laukik-hase/human_arm_imitation/README.md

# Imitation of Human Arm using a 5-DoF Manipulator

<!-- TABLE OF CONTENTS -->

## Table of Contents

- [Imitation of Human Arm using a 5-DoF Manipulator](#imitation-of-human-arm-using-a-5-dof-manipulator)
  - [Table of Contents](#table-of-contents)
  - [About The Project](#about-the-project)
  - [Contributors](#contributors)
  - [Resources](#resources)
  - [Acknowledgements](#acknowledgements)
  - [License](#license)

<!-- ABOUT THE PROJECT -->

## About The Project

- The project aims at develop a 5-DoF manipulator capable of precise imitation of the human arm. The manipulator will be tested in a simulated environment and then implemented in reality.

- The first challenge is to track the position of human joints and acquire joint parameters data.
A motion-capture system consisting of IMU sensors attached to the human arm will be used for the purpose.

- The next challenge is to map the motion of the human to the manipulator, with kinematic and dynamic
modeling of the manipulator for precise and accurate control.

- After establishing a stable system for arm imitation, it will be tested on applications like pick-and-place and tracing a curve.

- Everything about the project: reports, progress, demos (photos and videos) can be found [here](https://drive.google.com/drive/folders/1VRj0Rsg3wywi9sTcepC8vw8A19dxCz2f?usp=sharing).

- For detailed description of the project, view this [report](human_arm_imitation.pdf).

## Contributors

* [Vishnuparammal](https://github.com/Vishnuparammal)
* [ved29](https://github.com/ved29)
* [laukik-hase](https://github.com/laukik-hase)
* [ameya-apte](https://github.com/ameya-apte)

<!-- Acknowledgements and Resources-->

## Resources
- [Concept Development Report](https://drive.google.com/drive/folders/1PC-iJiLeUT0hi6oHv0CTknUYlQUyzkWc?usp=sharing)
- [Progress Status](https://drive.google.com/drive/folders/1OLMFB2oo_8WZqaWDnTHkVBi_Prd8paOJ?usp=sharing)
- [References](https://drive.google.com/drive/folders/1Bxyq7_aq28y-IdtfYdROcifC5CevMQnE?usp=sharing)
## Acknowledgements

- [AVITRA : 2019-2020](https://github.com/SRA-AVITRA)
- [AVITRA : 2018-2019](https://github.com/atharvkhadtare/fyp_ws)
- [AVITRA : 2017-2018](https://github.com/sachin0x18/Imitation)

<!-- LICENSE -->

## License

Distributed under the MIT License. See `LICENSE` for more information.
