laukik-hase/human_arm_imitation/arm_imitation/meshes/link1_MOI_calc_from_meshlab.png

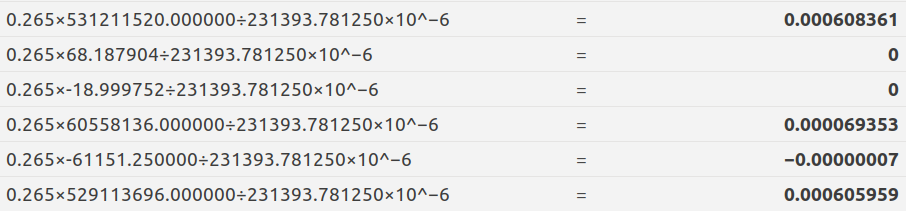
arm_imitation/meshes/link1_MOI_calc_from_meshlab.png
