laukik-hase/human_arm_imitation/arm_imitation/meshes/link2_MOI_calc_from_meshlab.png

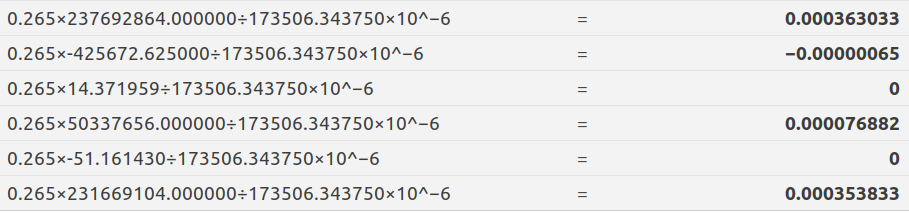
arm_imitation/meshes/link2_MOI_calc_from_meshlab.png
