laukik-hase/human_arm_imitation/arm_imitation/meshes/mx-64_MOI_calc_from_meshlab.png

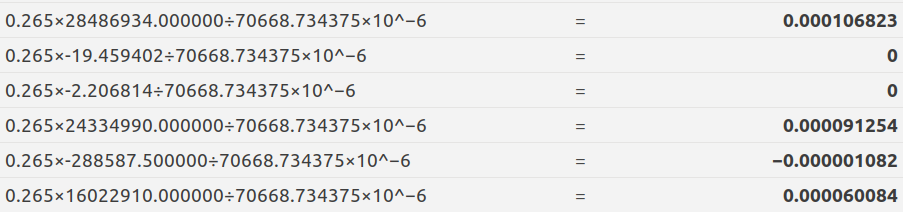
arm_imitation/meshes/mx-64_MOI_calc_from_meshlab.png
