laukik-hase/human_arm_imitation/pcb_designs/bno055/bno055.png

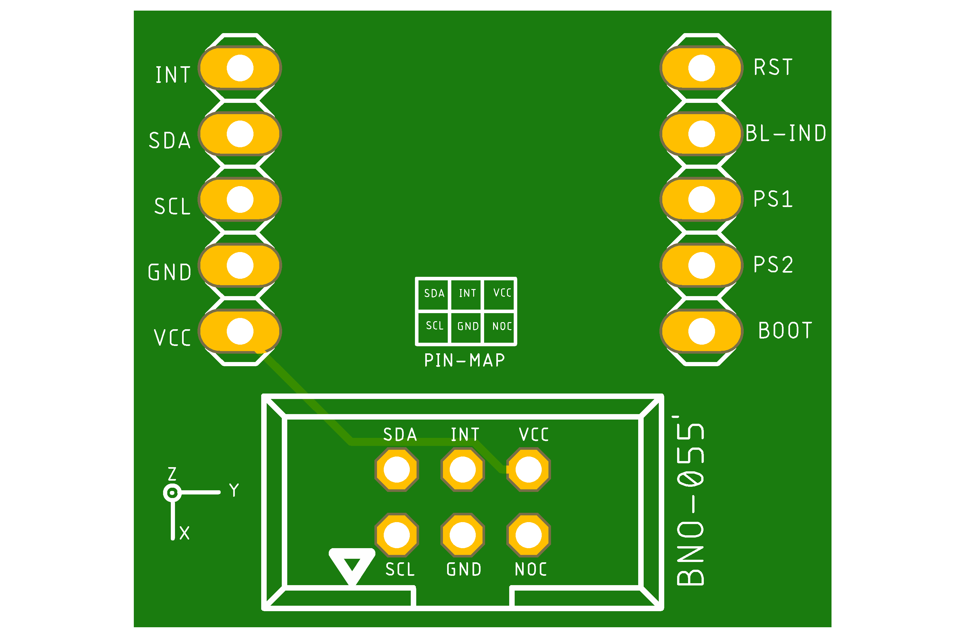
pcb_designs/bno055/bno055.png
