laukik-hase/human_arm_imitation/pcb_designs/esp32_breakout/fyp_board_rev4.png

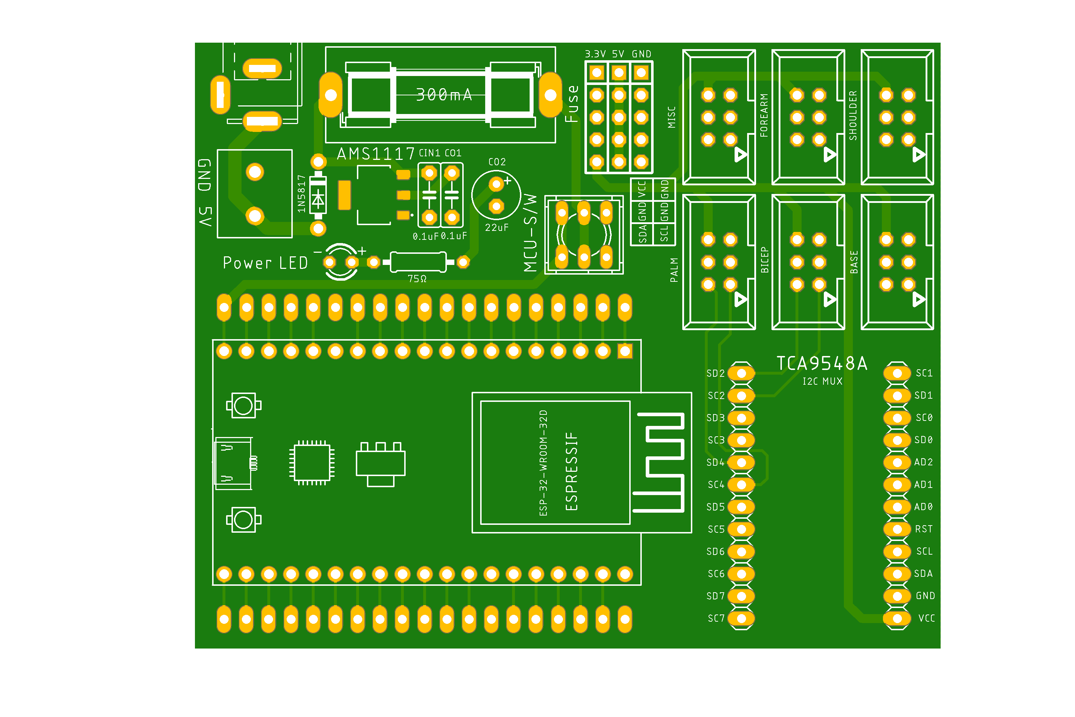
pcb_designs/esp32_breakout/fyp_board_rev4.png
