laukik-hase/human_arm_imitation/pcb_designs/mpu9250/mpu9250.png

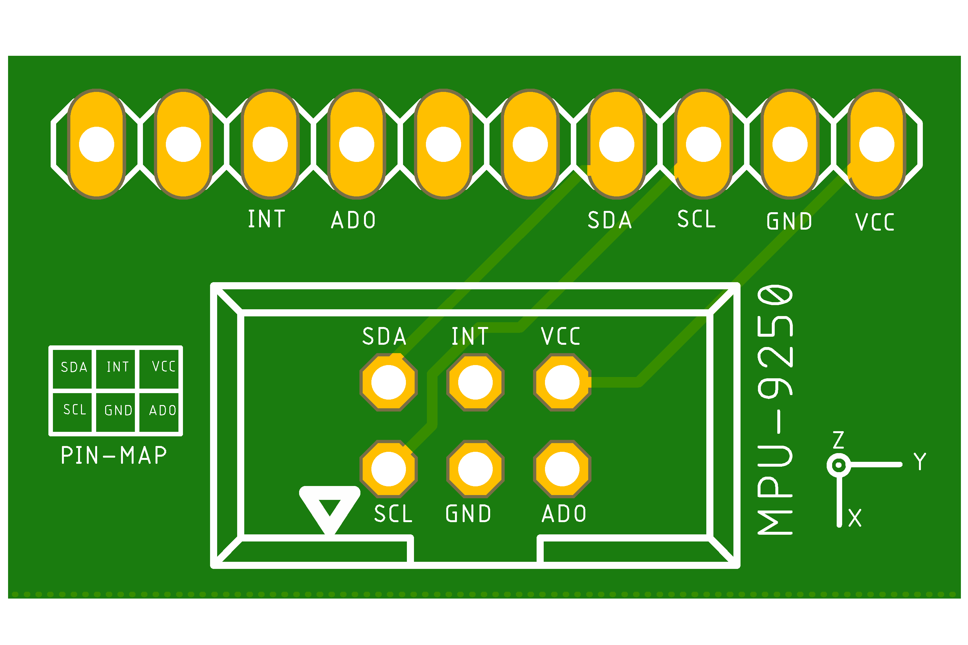
pcb_designs/mpu9250/mpu9250.png
