laukik-hase/human_arm_imitation/arm_imitation/launch/meshes/base_link.STL

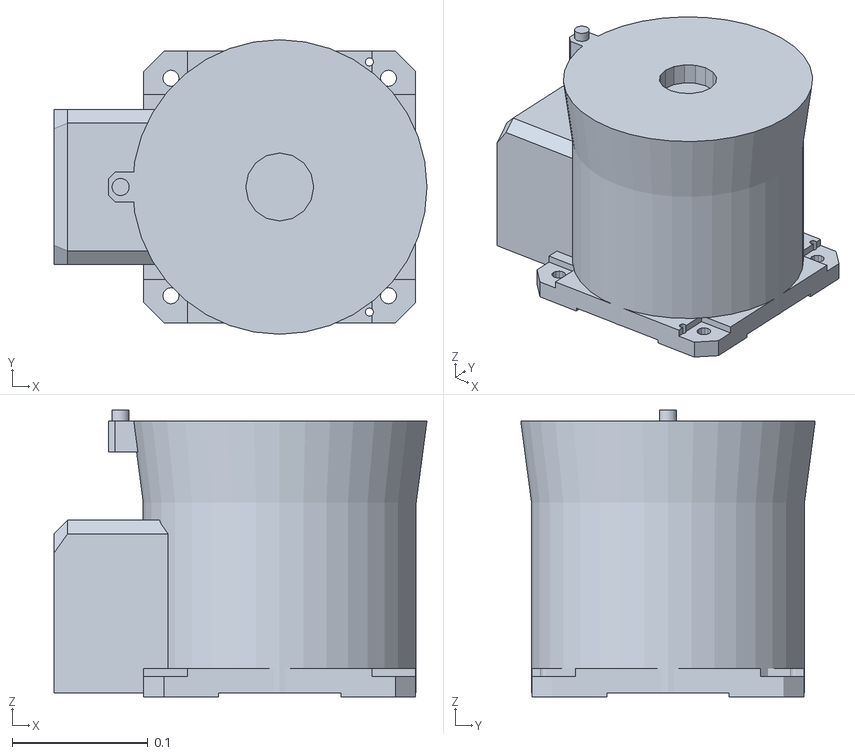
[picture p45: CAD file, 2021-05-06]
arm_imitation/launch/meshes/base_link.STL
0.274 x 0.217 x 0.211
