laukik-hase/human_arm_imitation/arm_imitation/meshes/link3.stl

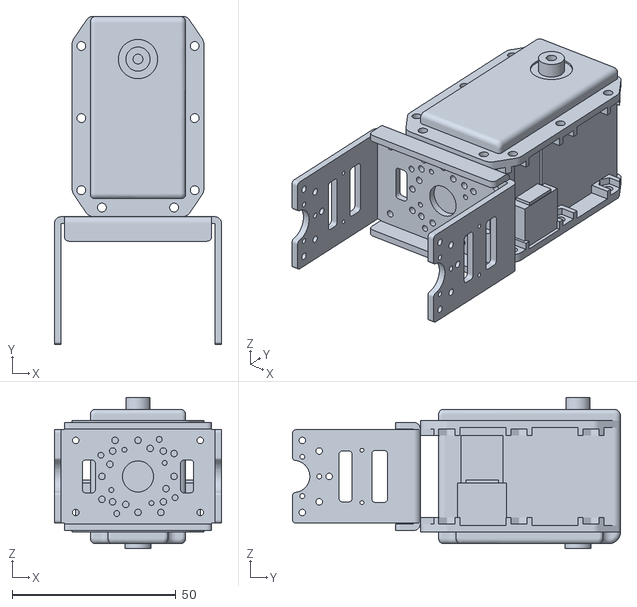
[picture p46: CAD file, 2021-05-06]
arm_imitation/meshes/link3.stl
51.0 x 100.1 x 46.1
