laukik-hase/human_arm_imitation/arm_imitation/meshes/step/FR05-H101.stp

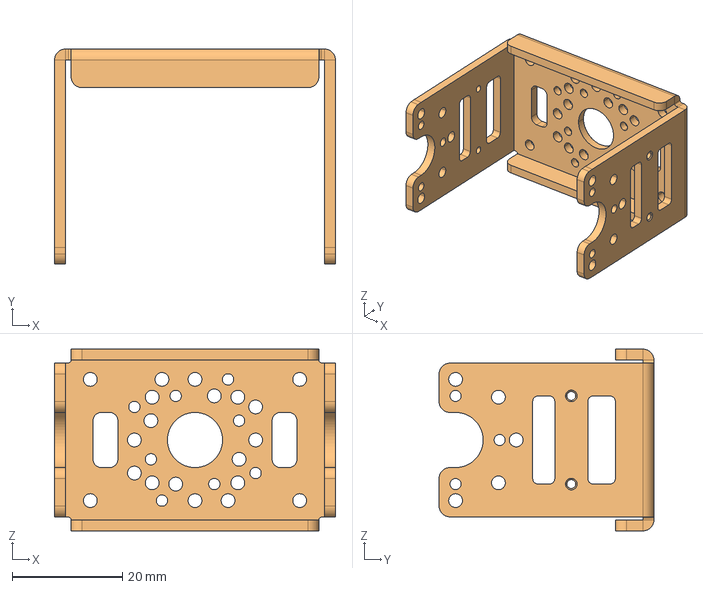
[picture p47: CAD file, 2021-04-16]
arm_imitation/meshes/step/FR05-H101.stp
51.0 x 39.0 x 33.0 mm
