laukik-hase/human_arm_imitation/arm_imitation/urdf/meshes/forearm.STL

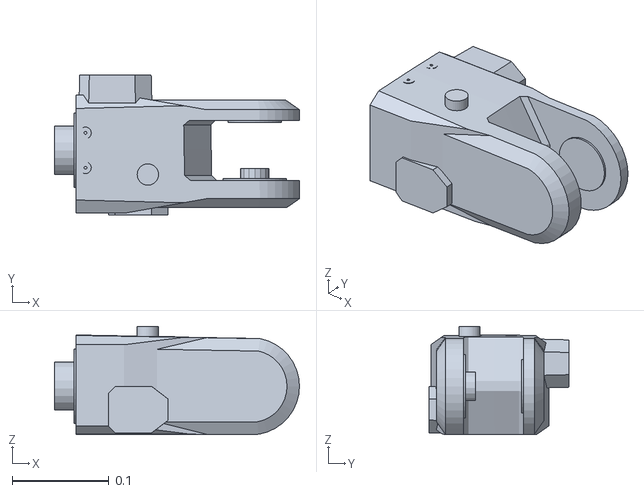
[picture p48: CAD file, 2021-05-06]
arm_imitation/urdf/meshes/forearm.STL
0.253 x 0.145 x 0.112
