laukik-hase/human_arm_imitation/arm_imitation/launch/meshes/bicep.STL

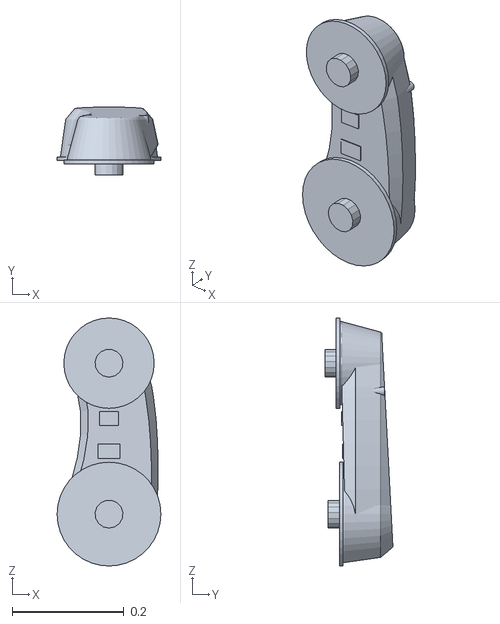
[picture p49: CAD file, 2021-05-06]
arm_imitation/launch/meshes/bicep.STL
0.186 x 0.121 x 0.444
