laukik-hase/human_arm_imitation/arm_imitation/meshes/link4.stl

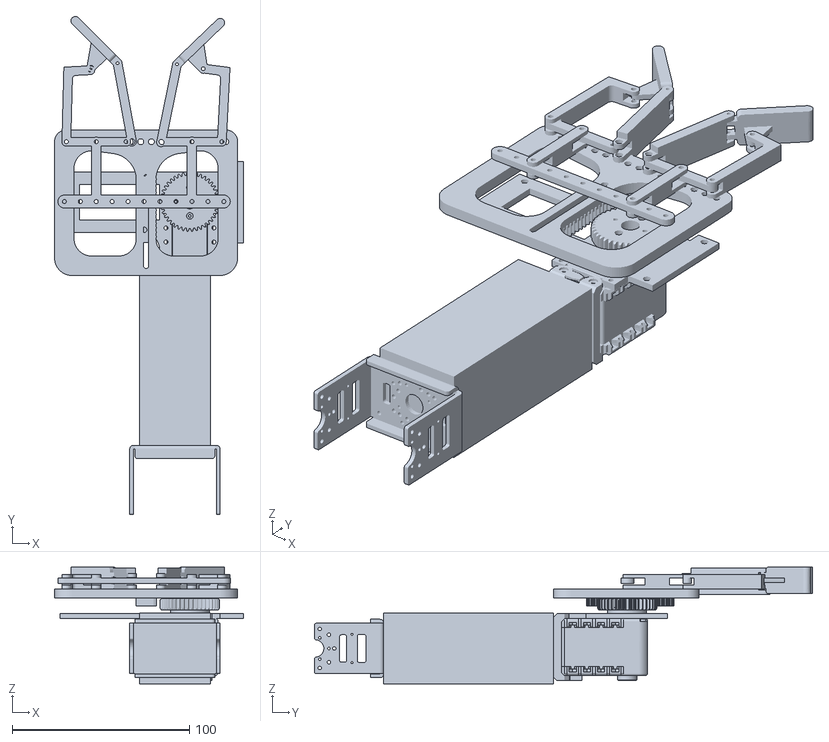
[picture p50: CAD file, 2021-05-06]
arm_imitation/meshes/link4.stl
106.6 x 281.0 x 65.9
