laukik-hase/human_arm_imitation/arm_imitation/urdf/meshes/shoulder.STL

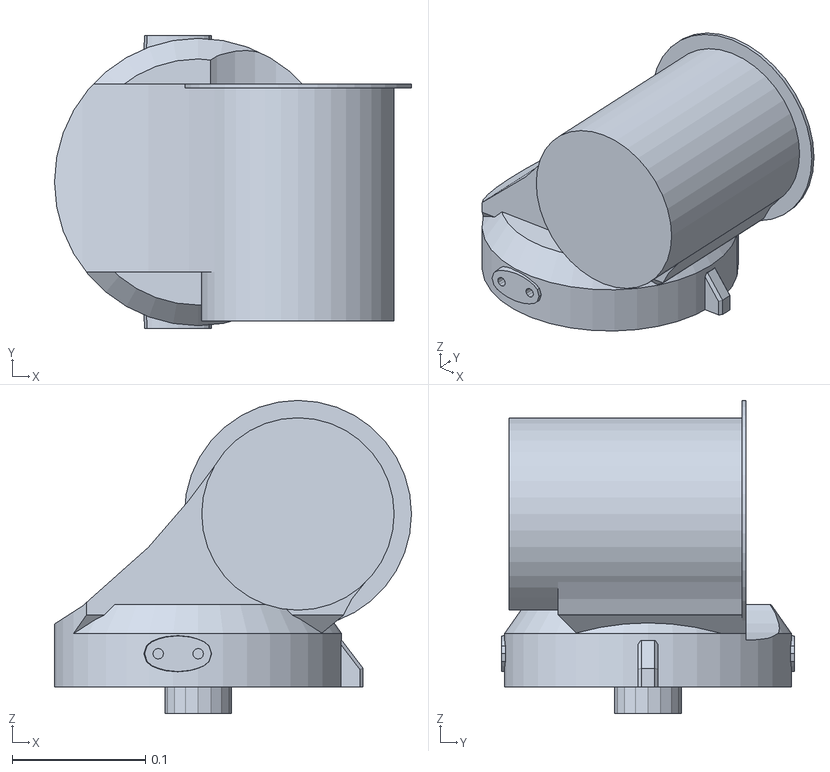
[picture p51: CAD file, 2021-05-06]
arm_imitation/urdf/meshes/shoulder.STL
0.268 x 0.22 x 0.235
