laukik-hase/human_arm_imitation/arm_imitation/launch/meshes/palm.STL

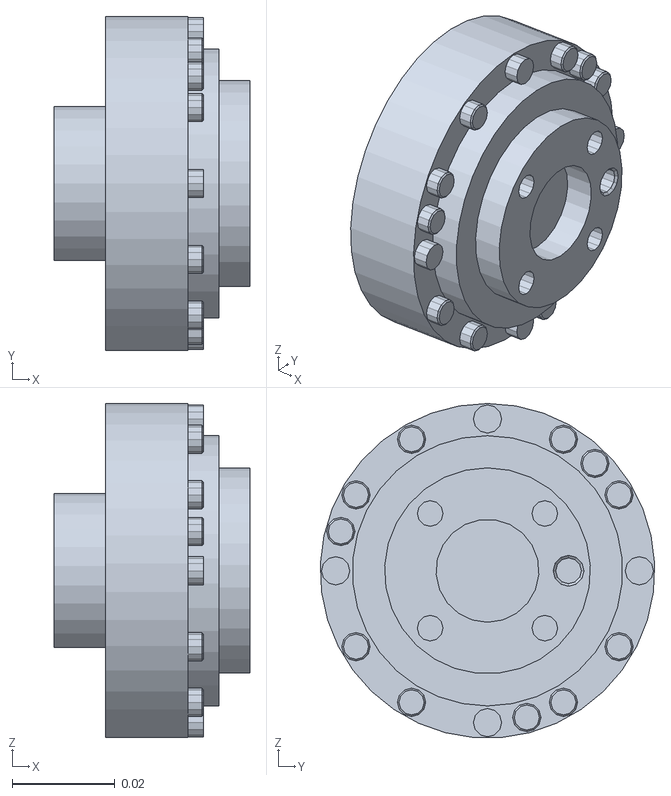
[picture p52: CAD file, 2021-05-06]
arm_imitation/launch/meshes/palm.STL
0.038 x 0.0649 x 0.0649
