laukik-hase/human_arm_imitation/arm_imitation/meshes/elbow.STL

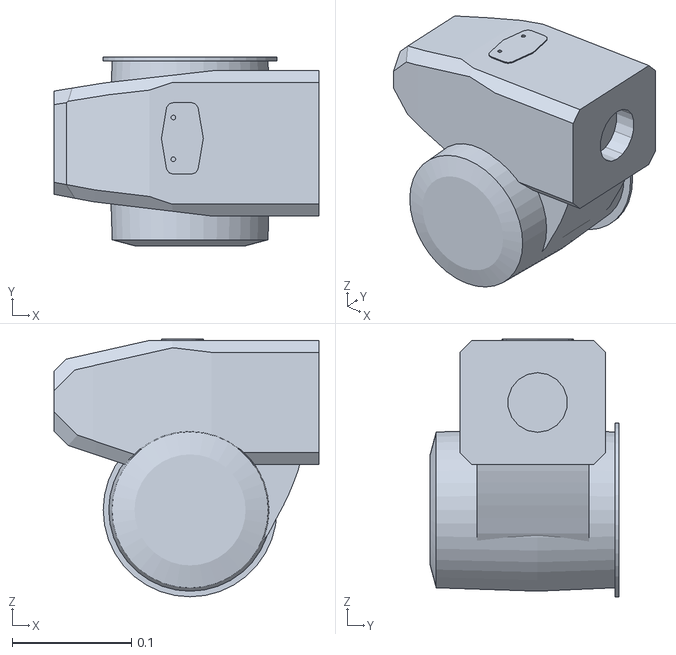
[picture p53: CAD file, 2021-05-06]
arm_imitation/meshes/elbow.STL
0.222 x 0.158 x 0.216
