laukik-hase/human_arm_imitation/arm_imitation/meshes/step/HN05_N102.stp

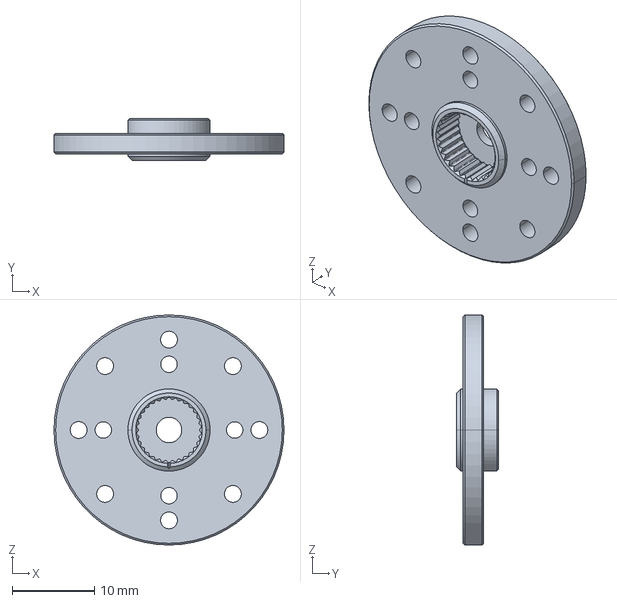
[picture p54: CAD file, 2021-04-13]
arm_imitation/meshes/step/HN05_N102.stp
28.0 x 5.10 x 28.0 mm
