laukik-hase/human_arm_imitation/arm_imitation/launch/meshes/wrist.STL

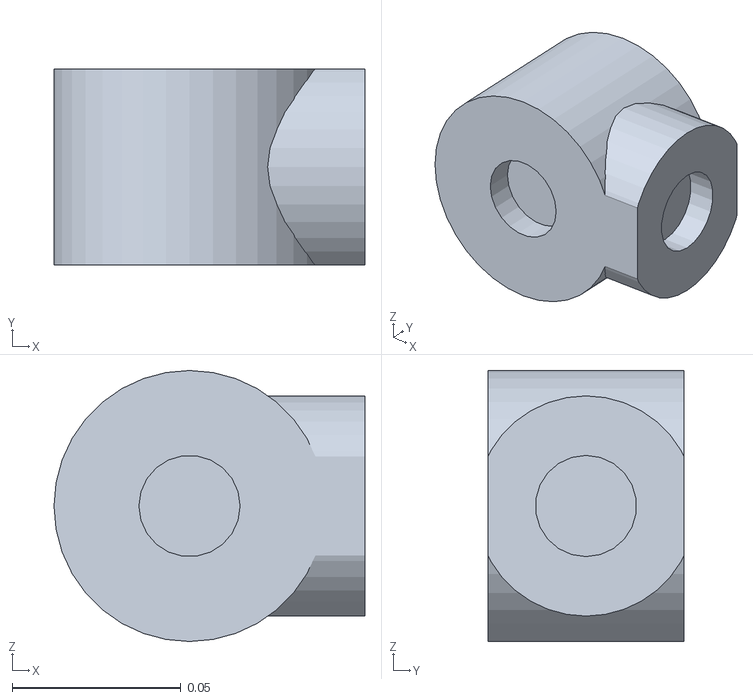
[picture p55: CAD file, 2021-05-06]
arm_imitation/launch/meshes/wrist.STL
0.0922 x 0.058 x 0.0803
