laukik-hase/human_arm_imitation/arm_imitation/meshes/mx-64.stl

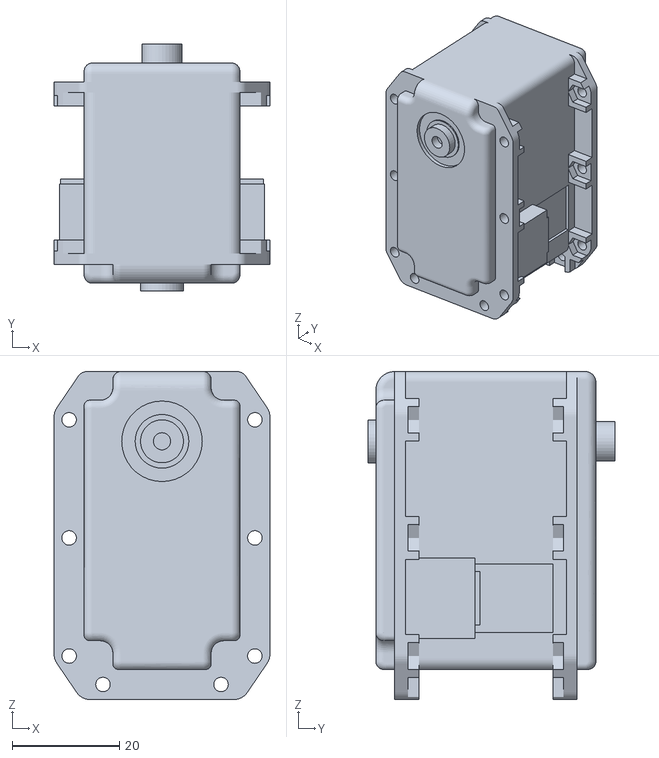
[picture p56: CAD file, 2021-04-16]
arm_imitation/meshes/mx-64.stl
40.2 x 46.1 x 61.1
