laukik-hase/human_arm_imitation/arm_imitation/meshes/link1.stl

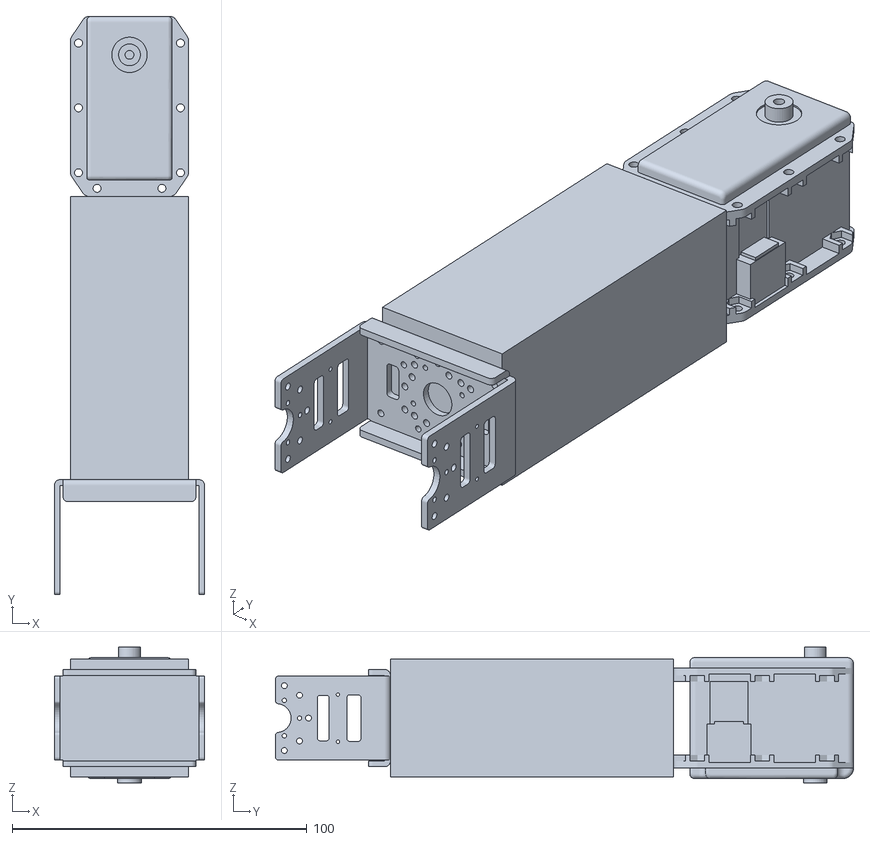
[picture p57: CAD file, 2021-04-16]
arm_imitation/meshes/link1.stl
51.0 x 196.1 x 46.1
