laukik-hase/human_arm_imitation/arm_imitation/meshes/link2.stl

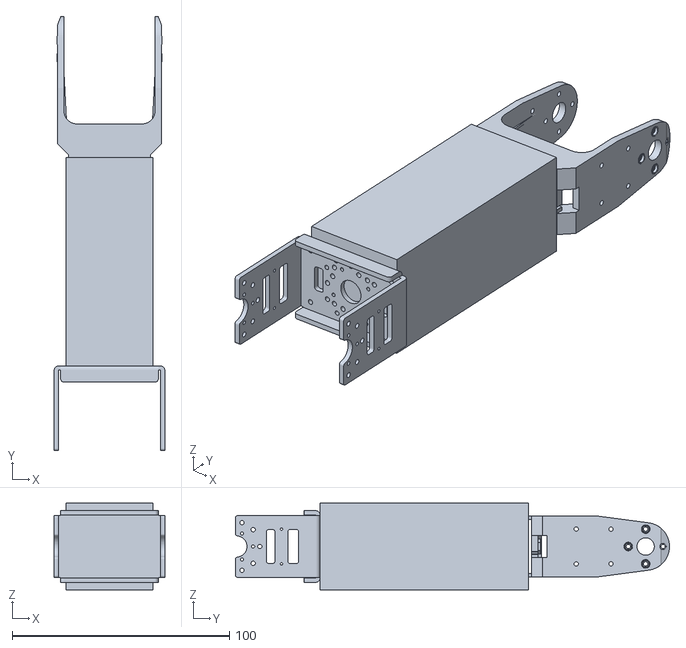
[picture p58: CAD file, 2021-04-16]
arm_imitation/meshes/link2.stl
51.0 x 200.0 x 40.0
