laukik-hase/human_arm_imitation/(list of files, cad)

Other CAD files:
arm_imitation/meshes/FR05-H101.stl
arm_imitation/meshes/HN05-i101.stl
arm_imitation/meshes/HN05_N102.stl
arm_imitation/meshes/blender/link1.blend
arm_imitation/meshes/blender/link2.blend
arm_imitation/meshes/blender/link3.blend
arm_imitation/meshes/blender/mx-64.blend
