laukik-hase/human_arm_imitation/resources/imu_joint_angle_sim/dataset/1/results_1.png

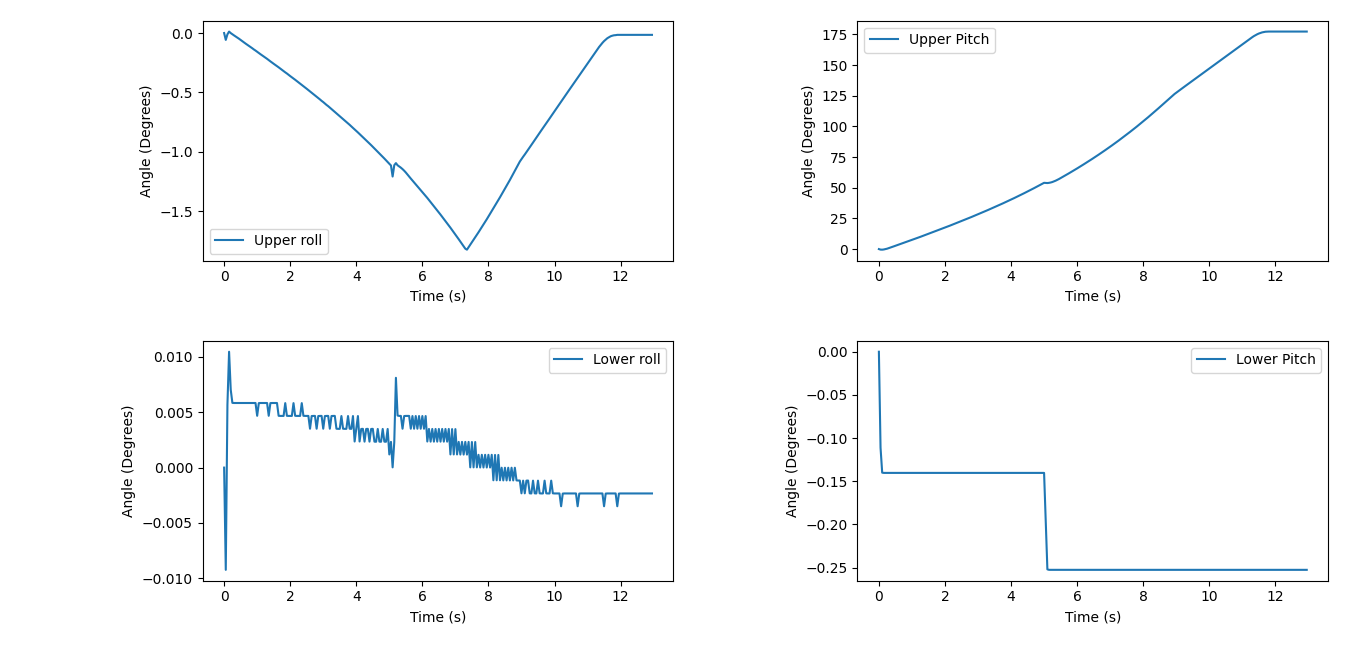
resources/imu_joint_angle_sim/dataset/1/results_1.png
