laukik-hase/human_arm_imitation/resources/imu_joint_angle_sim/dataset/2/results_2.png

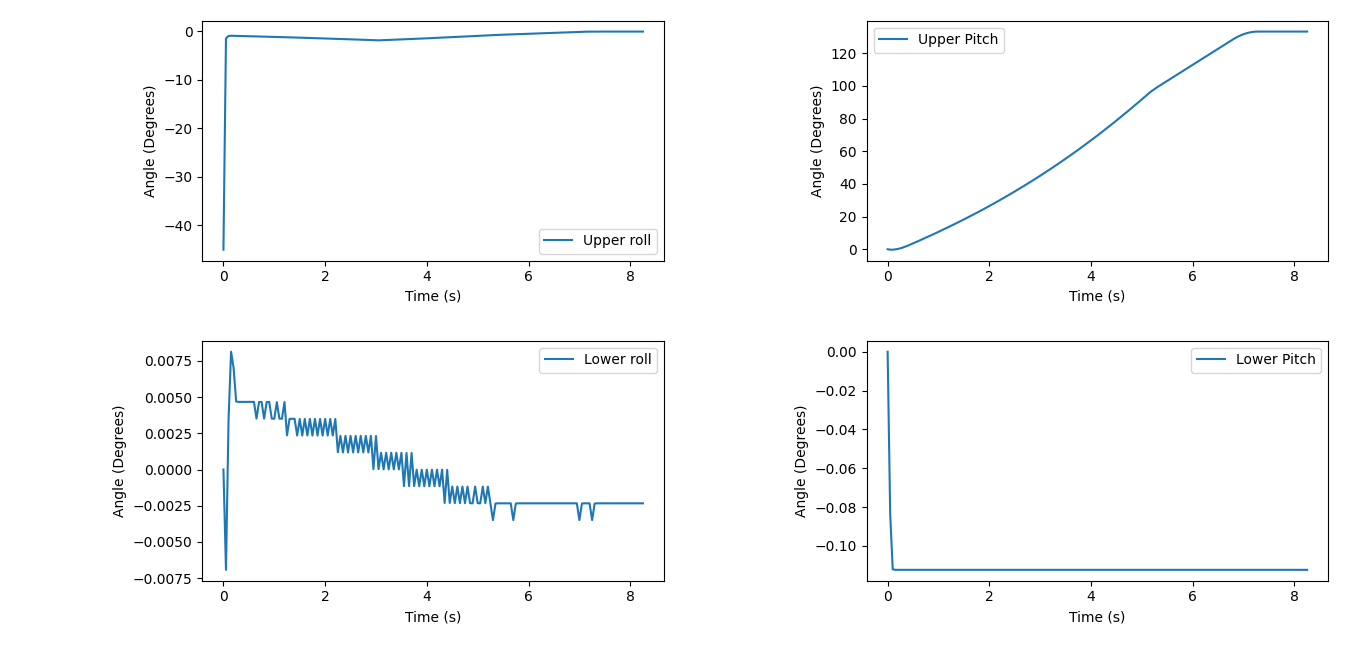
resources/imu_joint_angle_sim/dataset/2/results_2.png
