laukik-hase/human_arm_imitation/resources/imu_joint_angle_sim/dataset/4/results_4.png

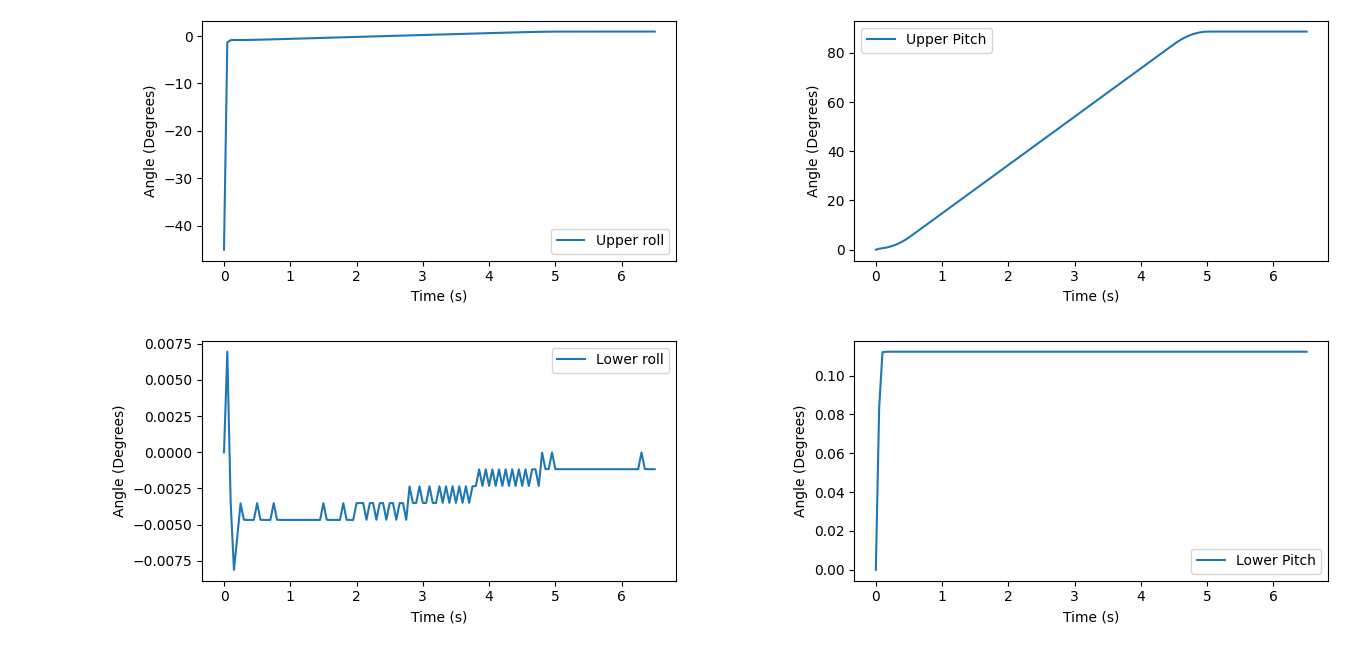
resources/imu_joint_angle_sim/dataset/4/results_4.png
