laukik-hase/human_arm_imitation/resources/imu_joint_angle_sim/dataset/5/results_5.png

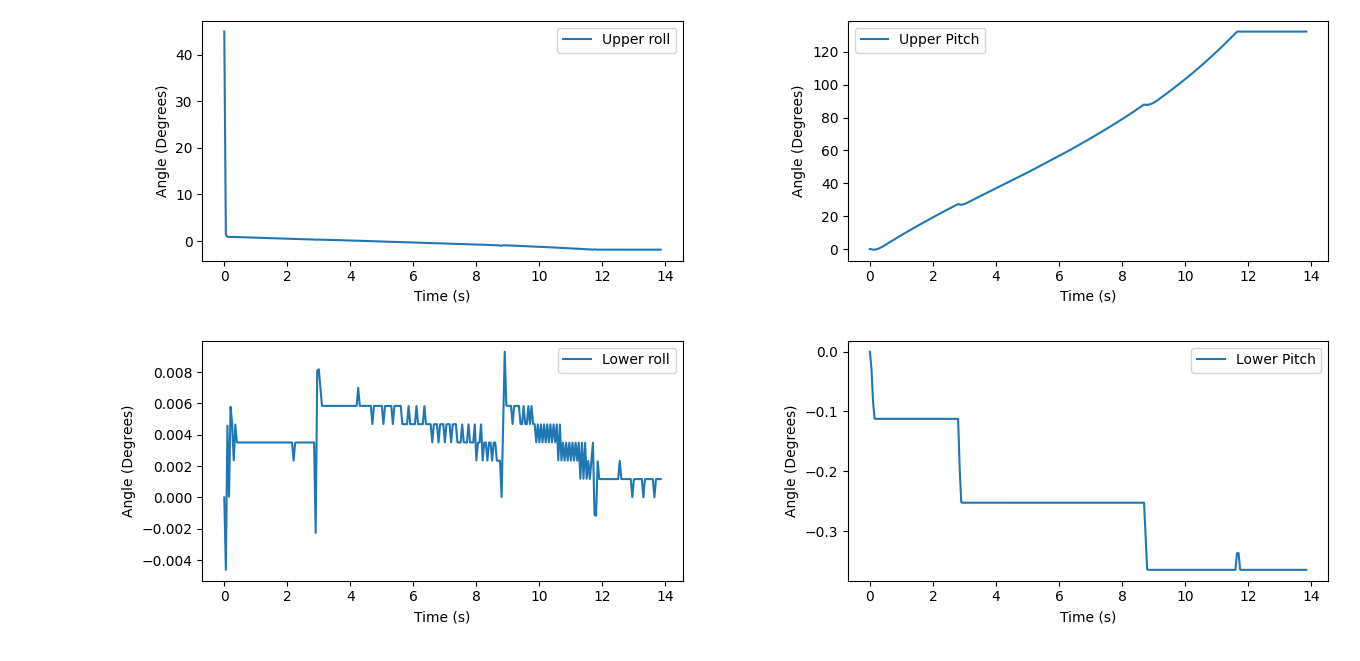
resources/imu_joint_angle_sim/dataset/5/results_5.png
