laukik-hase/human_arm_imitation/resources/imu_joint_angle_sim/dataset/6/results_6.png

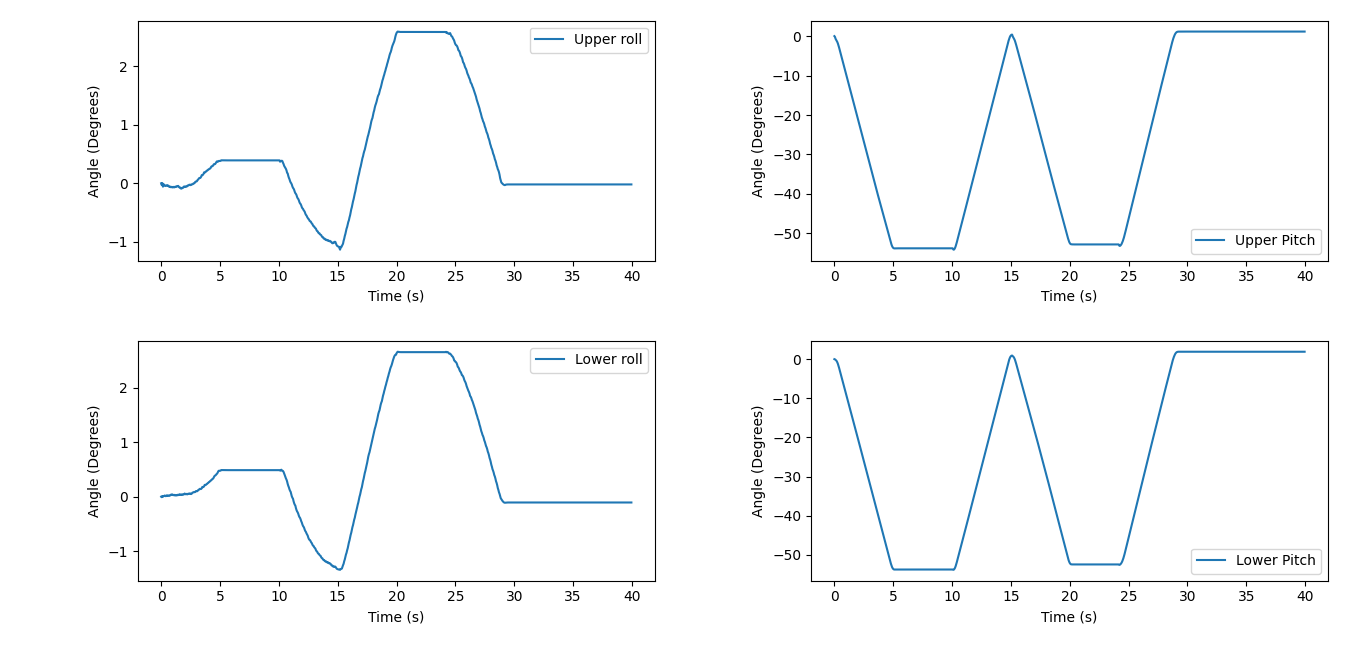
resources/imu_joint_angle_sim/dataset/6/results_6.png
