laukik-hase/human_arm_imitation/pcb_designs/esp32_breakout/fyp_board_rev4.brd

## EAGLE design pcb_designs/esp32_breakout/fyp_board_rev4.brd (2021-04-08)

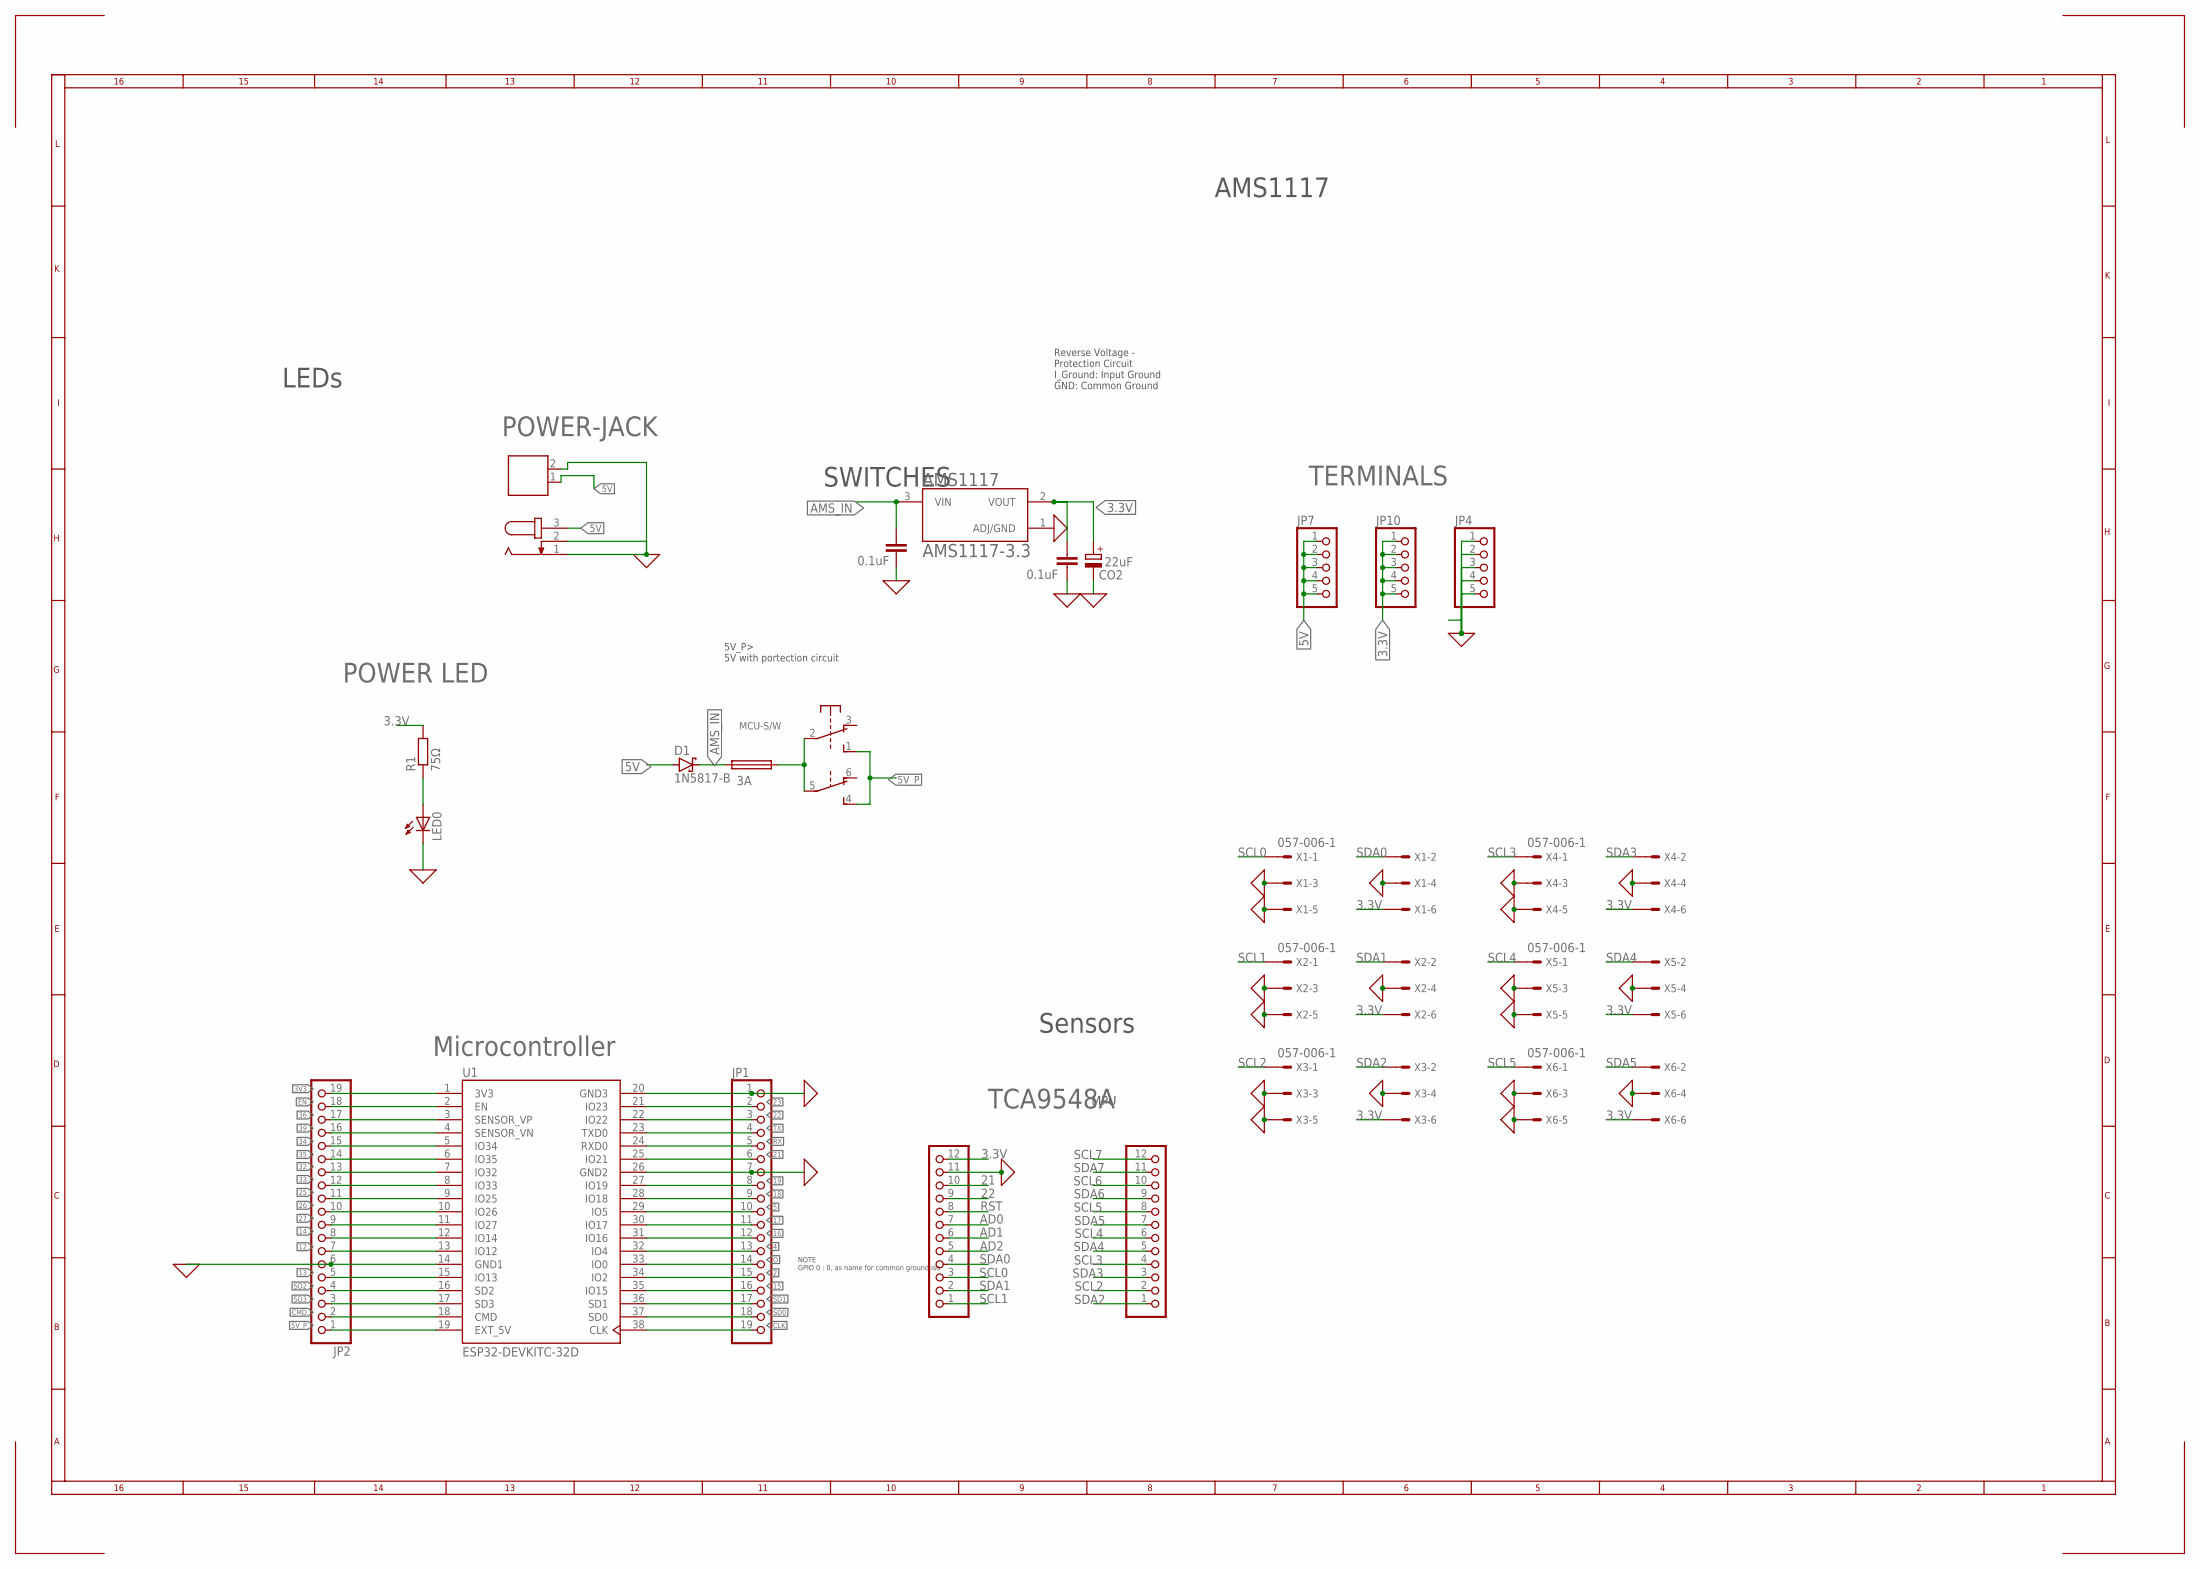
[picture p64: schematic fyp_board_rev4.sch]

Parts:
12V: 691131710002
AMS1117: AMS1117-3.3; SOT229P700X180-4N
CIN1: 0.1uF; C5B2.5
CO1: 0.1uF; C5B2.5
CO2: 22uF; E2,5-6
D1: 1N5817-B; DO41-7.6
F2: 3A; SH25
JP1, JP2: PINHD-1X19; 1X19
JP4, JP7, JP10: PINHD-1X5; 1X05
LED0: LED3MM
MCU-S/W: 9077-2
POWER-JACK: JACK-PLUG1; SPC4078
R1: 75Ω; 0207/10
SV2: PINHD-1X12; 1X12
TCA9548: PINHD-1X12; 1X12
U1: ESP32-DEVKITC-32D; MODULE_ESP32-DEVKITC-32D
X1, X2, X3, X4, X5, X6: 057-006-1

Connections:
0: 12V.2, AMS1117.1 (ADJ/GND), CIN1.1, CO1.1, CO2.-, JP1.1, JP1.7, JP2.6, JP4.1, JP4.2, JP4.3, JP4.4, JP4.5, LED0.K (C), POWER-JACK.1, POWER-JACK.2, TCA9548.11, U1.14 (GND1), U1.20 (GND3), U1.26 (GND2), X1.3, X1.4, X1.5, X2.3, X2.4, X2.5, X3.3, X3.4, X3.5, X4.3, X4.4, X4.5, X5.3, X5.4, X5.5, X6.3, X6.4, X6.5
2: JP1.15, U1.34 (IO2)
3.3V: AMS1117.2 (VOUT), CO1.2, CO2.+, JP10.1, JP10.2, JP10.3, JP10.4, JP10.5, R1.2, TCA9548.12, X1.6, X2.6, X3.6, X4.6, X5.6, X6.6
3V3: JP2.19, U1.1 (3V3)
4: JP1.13, U1.32 (IO4)
5: JP1.10, U1.29 (IO5)
5V: 12V.1, D1.A, JP7.1, JP7.2, JP7.3, JP7.4, JP7.5, POWER-JACK.3
5V_P: JP2.1, MCU-S/W.1 (S), MCU-S/W.4 (S), U1.19 (EXT_5V)
5_AF: F2.1, MCU-S/W.2, MCU-S/W.5
12: JP2.7, U1.13 (IO12)
13: JP2.5, U1.15 (IO13)
14: JP2.8, U1.12 (IO14)
15: JP1.16, U1.35 (IO15)
16: JP1.12, U1.31 (IO16)
17: JP1.11, U1.30 (IO17)
18: JP1.9, U1.28 (IO18)
19: JP1.8, U1.27 (IO19)
21: JP1.6, TCA9548.10, U1.25 (IO21)
22: JP1.3, TCA9548.9, U1.22 (IO22)
23: JP1.2, U1.21 (IO23)
25: JP2.11, U1.9 (IO25)
26: JP2.10, U1.10 (IO26)
27: JP2.9, U1.11 (IO27)
32: JP2.13, U1.7 (IO32)
33: JP2.12, U1.8 (IO33)
34: JP2.15, U1.5 (IO34)
35: JP2.14, U1.6 (IO35)
36: JP2.17, U1.3 (SENSOR_VP)
39: JP2.16, U1.4 (SENSOR_VN)
AD0: TCA9548.7
AD1: TCA9548.6
AD2: TCA9548.5
AMS_IN: AMS1117.3 (VIN), CIN1.2, D1.C, F2.2
CLK: JP1.19, U1.38 (CLK)
CMD: JP2.2, U1.18 (CMD)
EN: JP2.18, U1.2 (EN)
unnamed: LED0.A, R1.1
O: JP1.14, U1.33 (IO0)
RST: TCA9548.8
RX: JP1.5, U1.24 (RXD0)
SCL0: TCA9548.3, X1.1
SCL1: TCA9548.1, X2.1
SCL2: SV2.2, X3.1
SCL3: SV2.4, X4.1
SCL4: SV2.6, X5.1
SCL5: SV2.8, X6.1
SCL6: SV2.10
SCL7: SV2.12
SD0: JP1.18, U1.37 (SD0)
SD1: JP1.17, U1.36 (SD1)
SD2: JP2.4, U1.16 (SD2)
SD3: JP2.3, U1.17 (SD3)
SDA0: TCA9548.4, X1.2
SDA1: TCA9548.2, X2.2
SDA2: SV2.1, X3.2
SDA3: SV2.3, X4.2
SDA4: SV2.5, X5.2
SDA5: SV2.7, X6.2
SDA6: SV2.9
SDA7: SV2.11
TX: JP1.4, U1.23 (TXD0)

Notes on the sheet:
TERMINALS
Microcontroller
Reverse Voltage - Protection Circuit I_Ground: Input Ground GND: Common Ground
SWITCHES
5V_P> 5V with portection circuit
Sensors
MPU
NOTE GPIO 0 : 0, as name for common ground iso
AMS1117
LEDs
TCA9548A
POWER LED

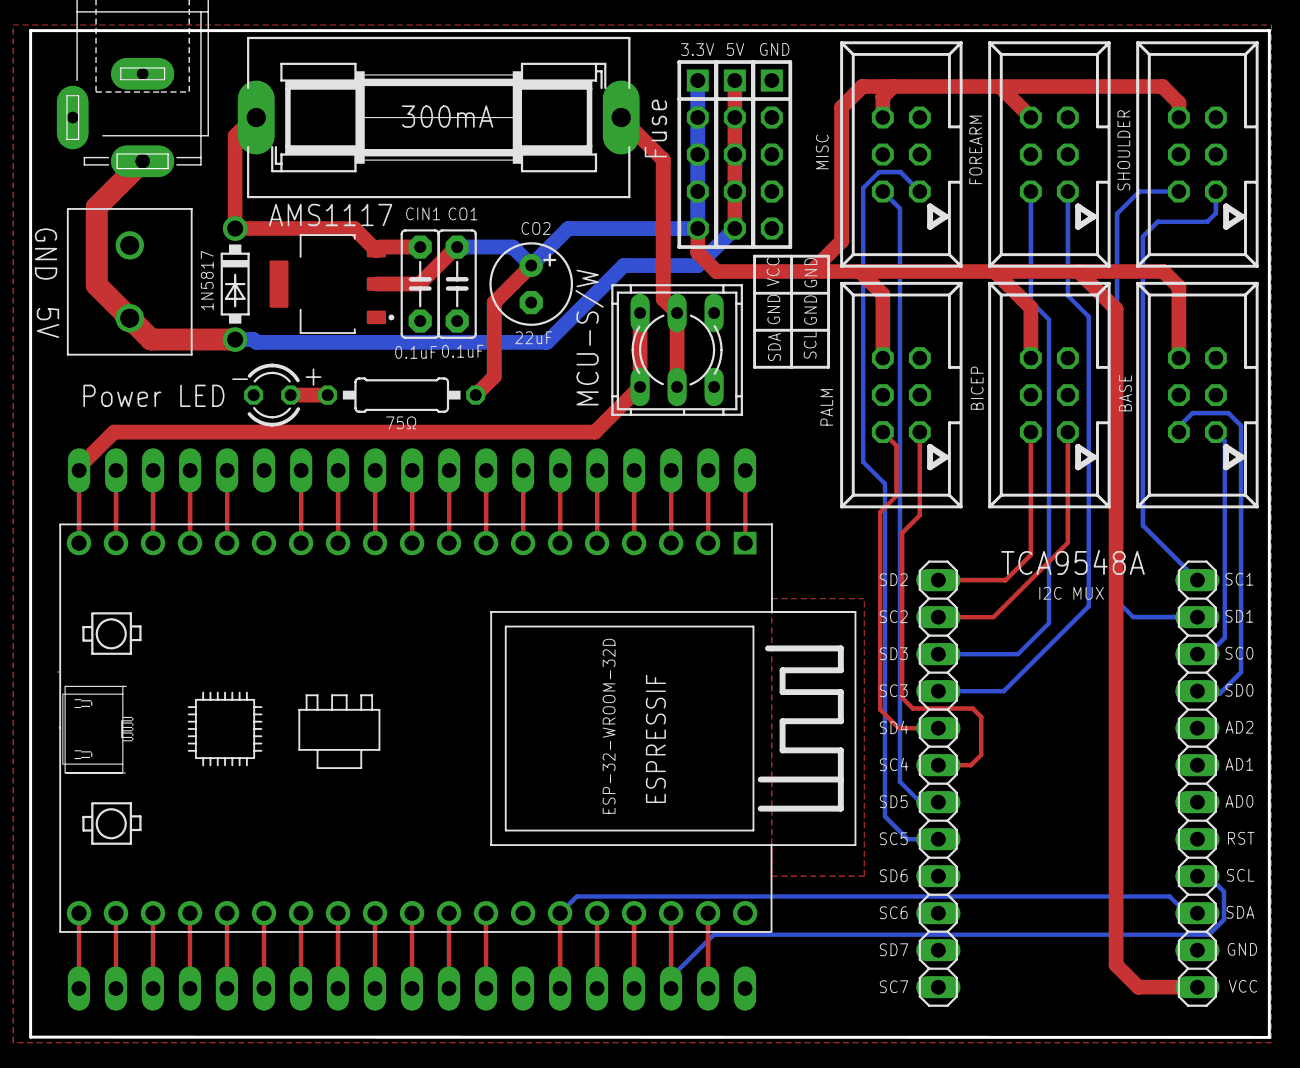
[picture p65: board fyp_board_rev4.brd from above]

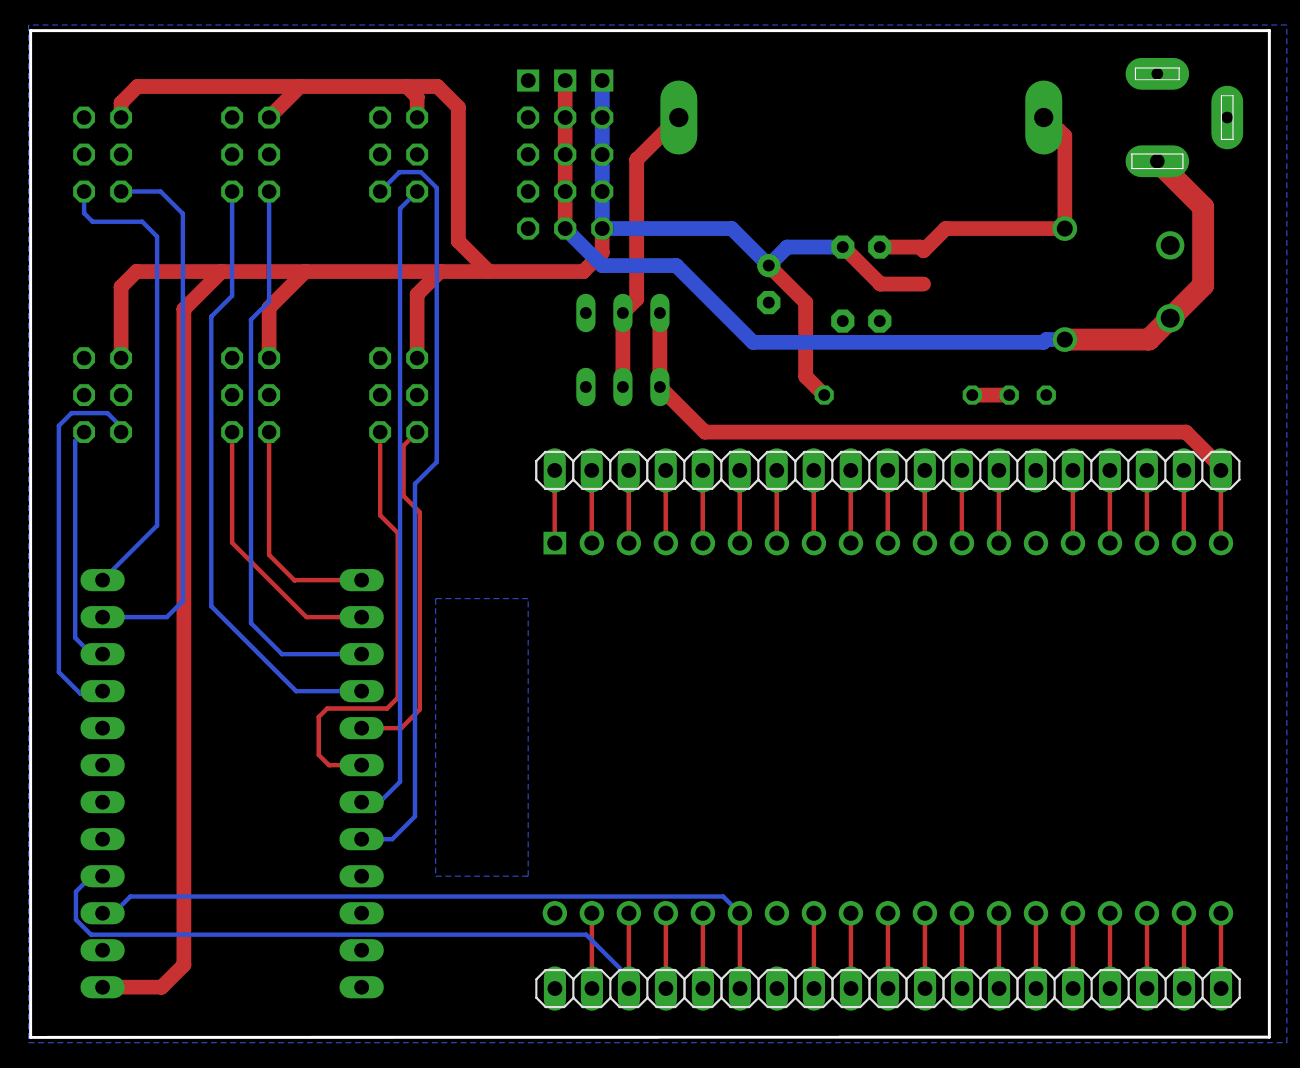
[picture p66: board fyp_board_rev4.brd from below]

Board: 2 copper layers, 85.0 x 69.1 mm, 25 parts (2 on the bottom side), 53 nets.
