laukik-hase/human_arm_imitation/pcb_designs/bno055/bno055.brd

## EAGLE design pcb_designs/bno055/bno055.brd (2021-04-08)

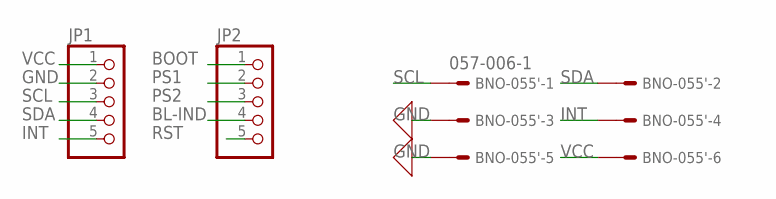
[picture p67: schematic bno055.sch]

Parts:
BNO-055': 057-006-1
JP1, JP2: PINHD-1X5; 1X05

Connections:
BL-IND: JP2.4
BOOT: JP2.1
GND: BNO-055'.3, BNO-055'.5, JP1.2
INT: BNO-055'.4, JP1.5
PS1: JP2.2
PS2: JP2.3
RST: JP2.5
SCL: BNO-055'.1, JP1.3
SDA: BNO-055'.2, JP1.4
VCC: BNO-055'.6, JP1.1

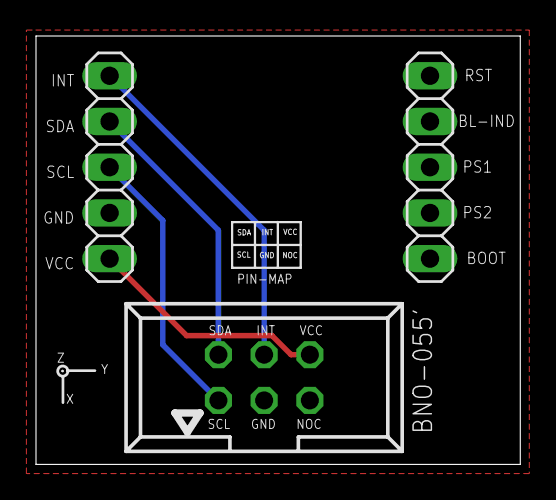
[picture p68: board bno055.brd from above]

Board: 2 copper layers, 26.9 x 23.8 mm, 3 parts (0 on the bottom side), 5 nets.
