laukik-hase/human_arm_imitation/dynaban/pypot/imitation_ineff.py

import paho.mqtt.client as paho 
import time
import Queue as queue
import json
import real_time_manipulator_math_utils
import pprint
import dynaban as dnb
import time
import pypot.robot
import pypot.dynamixel
import snoop 
import threading
import sys

pp = pprint.PrettyPrinter(indent=4)
# import rbdl
# import manip motion

broker = "broker.hivemq.com"
topic = "fyp/demo"
qos = 2


def on_message(client, userdata, message):
    msg = message.payload.decode("utf-8")
    
    q.put(msg)

def on_connect(client, userdata, flags, rc):
    client.subscribe(topic, qos)


client = paho.Client("client_001", clean_session=True)
client.on_connect = on_connect
client.on_message = on_message
print("Connecting to broker: ", broker)
client.max_queued_messages_set(256)
client.connect(broker, 1883)
client.loop_start()
loop_flag = 1
q = queue.Queue()
count = 1

SPLINE = 1
WINDOWSIZE = 5
# MOTOR_ID = [1,2,3,4]
MOTOR_ID = [1]
angle_limit = [[-10,100],[90,270]]
JOINTS = len(MOTOR_ID)
GRIPPER_ID = 5

db = dnb.dynaban(MOTOR_ID, GRIPPER_ID)
math_utils_obj = real_time_manipulator_math_utils.manipulator_math_utils(JOINTS)
timestamps = []
angles = []
[angles.append([]) for j in range(JOINTS)]
torques = []
[torques.append([]) for j in range(JOINTS)]
padded_angles = []
first_val = True
mqtt_initval_error = True
gripper_state = False # false = open
traj1 = []
prev_traj2 = []
once = True
last_flag = True
coeff_angle = []
cats_transform = [[1,180],[1,180],[-1,180],[1,180]] #current angle to steps (cats)

ports = pypot.dynamixel.get_available_ports()

if not ports:
    raise IOError('no port found!')

print('ports found', ports)

print('connecting on the first available port:', ports[0])

dxl_io = pypot.dynamixel.DxlIO(ports[0])
#         dxl_io.enable_torque({self.GRIPPER_ID: 1})
time.sleep(0.1)    


def init_motor():

    for joints in range(len(MOTOR_ID)):

        num = MOTOR_ID[joints]
        dxl_io.set_mode_dynaban({1:0})
#         dxl_io.set_mode_dynaban({num:1})
#             time.sleep(0.1)
        dxl_io.enable_torque({num:1})
#             time.sleep(0.1)
#         dxl_io.set_pid_gain({MOTOR_ID[joints]:[1,0,0]})
#             time.sleep(0.1)
#     dxl_io.enable_torque({1:0,2:0,3:0,4:0})
    # dxl_io.set_angle_limit({1:[-10.0,150.0],2:[-90.0,90.0]})

def reset_motor():
    
    for joints in range(len(MOTOR_ID)):

        num = MOTOR_ID[joints]
        dxl_io.set_mode_dynaban({num:0})
        dxl_io.enable_torque({num:0})
    time.sleep(0.1)
    init_motor()
    
def clear_reg():

    for joints in range(len(MOTOR_ID)):
        
        dxl_io.set_a0_traj1({MOTOR_ID[joints] : 0.0})
        dxl_io.set_a1_traj1({MOTOR_ID[joints] : 0.0})
        dxl_io.set_a2_traj1({MOTOR_ID[joints] : 0.0})
        dxl_io.set_a3_traj1({MOTOR_ID[joints] : 0.0})
                    

def rewrite_reg(id, traj2):
        
        dxl_io.set_a0_traj1({MOTOR_ID[id] : traj2[id][0]})
        dxl_io.set_a1_traj1({MOTOR_ID[id] : traj2[id][1]})
        dxl_io.set_a2_traj1({MOTOR_ID[id] : traj2[id][2]})
        dxl_io.set_a3_traj1({MOTOR_ID[id] : traj2[id][3]})
#                     traj2 = []
    
def go_to_start_pos(init_angle):
        
        for joints in range(len(MOTOR_ID)):
            num = MOTOR_ID[joints]
            start_angle = int(init_angle[joints])
            print("start angle",start_angle)
            current_pos = int(dxl_io.get_present_position([num])[0])
            diff = abs(current_pos-start_angle)
            print("diff", diff)
            for i in range(diff):
                if (current_pos > start_angle):
                    dxl_io.set_goal_position({MOTOR_ID[joints]:current_pos - i})
                    time.sleep(0.05) 
                else:
                    dxl_io.set_goal_position({MOTOR_ID[joints]:current_pos + i})
                    time.sleep(0.05)
#         q.empty()

def limit_poly(curr_ang,transform,limit):
    b = transform[0]*curr_ang + transform[1]
    a = (transform[0]*limit + transform[1] - b) /1
    return a,b

def setTraj1( id, duration, coeffs):
    errorCounter = 0
    delay = 0.001
    while True:
        try:
            dxl_io.set_traj1_size({id: 4})
            time.sleep(delay)
            dxl_io.set_duration1({id: duration})
            time.sleep(delay)
            dxl_io.set_a0_traj1({id: coeffs[0]})
            time.sleep(delay)
            dxl_io.set_a1_traj1({id: coeffs[1]})
            time.sleep(delay)
            dxl_io.set_a2_traj1({id: coeffs[2]})
            time.sleep(delay)
            dxl_io.set_a3_traj1({id: coeffs[3]})
            time.sleep(delay)
#             dxl_io.set_a4_traj1({id: coeffs[4]})
#             time.sleep(delay)

            break
        except:
            errorCounter = errorCounter + 1
            # print "Nope :/"
            break
            print("nb errors1 = ", errorCounter)


def setTraj2(id, duration, coeffs):
    errorCounter = 0
    delay = 0.001

    while True:
        try:
            dxl_io.set_traj2_size({id: 4})
            time.sleep(delay)
            dxl_io.set_duration2({id: duration})
            time.sleep(delay)
            dxl_io.set_a0_traj2({id: coeffs[0]})
            time.sleep(delay)
            dxl_io.set_a1_traj2({id: coeffs[1]})
            time.sleep(delay)
            dxl_io.set_a2_traj2({id: coeffs[2]})
            time.sleep(delay)
            dxl_io.set_a3_traj2({id: coeffs[3]})
            time.sleep(delay)
#             dxl_io.set_a4_traj2({id: coeffs[4]})
#             time.sleep(delay)

            break
        except:
            errorCounter = errorCounter + 1
            print("nb errors2 = ", errorCounter)
            break

                
while loop_flag==1:
        # threading.enumerate()
#     try: 
        if count == 1:
            message = q.get()
            msg = json.loads(message)
            print(msg)
            init_timestamp = msg['timestamp']
    #             init_angle = [-msg['shoulder']['pitch'],msg['shoulder']['roll'],msg['shoulder']['yaw'],-msg['elbow']['pitch']-90]
    #             init_angle = [-msg['shoulder']['pitch'],-msg['elbow']['pitch']-90]
            init_angle = [-msg['shoulder']['pitch']]
            # print("###########################")
            # client.unsubscribe(topic)
            # print("Hello unsub")
            
            init_motor()
            go_to_start_pos(init_angle)
            # client.subscribe(topic, qos)
            count = 2
        
        else:
            # print(len(q))
            message = q.get()
            msg = json.loads(message)
            print(msg['timestamp'], " ", msg['shoulder']['pitch'])

#         if mqtt_initval_error:
#             mqtt_initval_error = False
#             continue
#             print(msg['timestamp'] - init_timestamp)
            if(msg['timestamp'] - init_timestamp >= SPLINE):

                init_timestamp = msg['timestamp']
                
                for j in range(JOINTS):
                    if padded_angles == []:
                        angles[j] = [angles[j][0]]*(WINDOWSIZE-1) + angles[j]
                    else:
                        angles[j] = padded_angles[j] + angles[j]

                padded_angles = [ angles[j][-(WINDOWSIZE-1):] for j in range(JOINTS) ]


                angles = math_utils_obj.real_time_moving_average(angles,WINDOWSIZE)
#                 transformation = [[-1,180],[1,180],[-1,180],[-1,90]]
                transformation = [[-1,180]]
                angles = math_utils_obj.angles_to_steps(angles, transformation)
                coeff_angle = math_utils_obj.calculate_coefficients_angles(timestamps, angles)
#                 print("angles coefficients")
#                 pp.pprint(coeff_angle)


            if coeff_angle != []:
                if once:
                    for joints in range(len(MOTOR_ID)):
                        setTraj1(MOTOR_ID[joints],SPLINE*10000, [coeff_angle[joints][3],coeff_angle[joints][2],coeff_angle[joints][1],coeff_angle[joints][0]])

                    dxl_io.set_mode_dynaban(db.DXL_DICT_3)
#                     dxl_io.set_mode_dynaban({1:3})            

                    coeff_angle = []
                    once = False
            

                else:
#                     print(coeff_angle)
                    # for joints in range(len(MOTOR_ID)):
                    #     setTraj2(MOTOR_ID[joints],SPLINE*10000, [coeff_angle[joints][3],coeff_angle[joints][2],coeff_angle[joints][1],coeff_angle[joints][0]])
                    
                    # dxl_io.set_copy_next_buffer(db.DXL_DICT_1)

# #                     dxl_io.set_copy_next_buffer({2:1})
                    

                            
                    
                                              
                    # traj1 = []
                    # for joints in range(len(MOTOR_ID)):
                        
                    #     traj1.append([dxl_io.get_a0_traj1([MOTOR_ID[joints]])[0],dxl_io.get_a1_traj1([MOTOR_ID[joints]])[0],dxl_io.get_a2_traj1([MOTOR_ID[joints]])[0],dxl_io.get_a3_traj1([MOTOR_ID[joints]])[0]])
                    
                    # traj2 = []
                    # for joints in range(len(MOTOR_ID)):
                    #      traj2.append([dxl_io.get_a0_traj2([MOTOR_ID[joints]])[0],dxl_io.get_a1_traj2([MOTOR_ID[joints]])[0],dxl_io.get_a2_traj2([MOTOR_ID[joints]])[0],dxl_io.get_a3_traj2([MOTOR_ID[joints]])[0]])
                            
                    # if last_flag:
                    #     prev_traj2 = traj1
                    #     last_flag = False
#                     print(prev_traj2[0][0])  
#                     dxl_io.set_a0_traj1({1: 2306.0})
                        
                    
#                     print("traj1" ,traj1)
#                     print("prev_traj2" , prev_traj2)
            
                    for i in range(len(MOTOR_ID)):
                        
                        # if prev_traj2[i] != traj1[i]:
                        print("not same")
                        rewrite_reg(i, [[coeff_angle[i][3],coeff_angle[i][2],coeff_angle[i][1],coeff_angle[i][0]]])
                        dxl_io.set_mode_dynaban({MOTOR_ID[i]:3})

                            
                            
#                         dxl_io.set_mode_dynaban({1:3})
                        
#                         
                    prev_traj2 = []
                    for joints in range(len(MOTOR_ID)):
                         prev_traj2.append([dxl_io.get_a0_traj2([MOTOR_ID[joints]])[0],dxl_io.get_a1_traj2([MOTOR_ID[joints]])[0],dxl_io.get_a2_traj2([MOTOR_ID[joints]])[0],dxl_io.get_a3_traj2([MOTOR_ID[joints]])[0]])

    #                         self.setTorque2(self.MOTOR_ID[joints],spline*10000, [coeff_torque[joints][3],coeff_torque[joints][2],coeff_torque[joints][1],coeff_torque[joints][0]])
            
                    
                
#                     dxl_io.set_copy_next_buffer(db.DXL_DICT_1)
                   
                    coeff_angle = []
                    current_angle = []    
                        
                    # time.sleep(1)
#                     my_time_start = time.time()
#                     while (time.time() - my_time_start < 1):
#                         for joints in range(len(MOTOR_ID)):
#                             current_angle = dxl_io.get_present_position([MOTOR_ID[joints]])[0]
# #                             print(current_angle)
#                             if (current_angle < angle_limit[joints][0] or current_angle > angle_limit[joints][1]):
#                                 print(joints, " out of range")
#                                 dxl_io.set_mode_dynaban({1:0})
#                                 time.sleep(0.2)
#                                 go_to_start_pos([angle_limit[joints][1]-2] )
#                                 time.sleep(0.8)
#                                 if current_angle < angle_limit[joints][0]:
#                                     a,b = limit_poly(current_angle,cats_transform[joints],angle_limit[joints][0])
#                                     if MOTOR_ID[joints] == 3: 
#                                         a += 56
#                                     else: 
#                                         a -= 56
# #                                     clear_reg()
#                                     rewrite_reg(joints, [[b,a,0.0,0.0]])
#                                     dxl_io.set_mode_dynaban({MOTOR_ID[joints]:3})
#                                     time.sleep(1)
# #                                     setTraj1(MOTOR_ID[joints],10000, [b,a,0.0,0.0])
# # #                                     time.sleep(0.1)
# #                                     dxl_io.set_mode_dynaban(db.DXL_DICT_3)
#                                     print("#####")
#                                 else:
#                                     a,b = limit_poly(current_angle,cats_transform[joints],angle_limit[joints][1])
#                                     if MOTOR_ID[joints] == 3: 
#                                         a -= 56
#                                     else: 
#                                         a += 56
# #                                     clear_reg()
#                                     rewrite_reg(joints, [[b,a,0.0,0.0]])
#                                     dxl_io.set_mode_dynaban({MOTOR_ID[joints]:3})
#                                     print("#####")
#                                     time.sleep(1)
                                

                                # sys.exit()
                                # dxl_io.enable_torque({1:0,2:0,3:0,4:0}) 
                                
                                                
                    # time.sleep(SPLINE)
#                     print("get a1 for traj1" ,dxl_io.get_a0_traj1([MOTOR_ID[0]]))
#                     print("get a1 for traj2" ,dxl_io.get_a0_traj2([MOTOR_ID[0]]))



                # empty
                timestamps = []
                angles = []
                [angles.append([]) for j in range(JOINTS)]
                torques = []
                [torques.append([]) for j in range(JOINTS)]

        timestamps.append(msg['timestamp'] - init_timestamp)
        angles[0].append(msg['shoulder']['pitch'])
#         angles[1].append(msg['shoulder']['roll'])
#         angles[0].append(msg['shoulder']['pitch'])
    #     angles[3].append(msg['shoulder']/['pitch'])
#         angles[1].append(msg['shoulder']['roll'])
#         angles[2].append(msg['shoulder']['yaw'])
#         angles[3].append(msg['elbow']['pitch'])
#     except:
#         print("termios error")
#         pass

client.disconnect()
client.loop_stop()
