laukik-hase/human_arm_imitation/dynaban/pypot/mqtt_listener_rospub.py

import rospy
from std_msgs.msg import String
import paho.mqtt.client as paho

broker = "broker.hivemq.com"
topic = "fyp/qos"
qos = 1
count = 0
def on_message(client, userdata, message):
    global count
    msg = message.payload.decode("utf-8")
    count = 1 
    # pub.publish(msg)
    print("Received: ", msg)

def on_connect(client, userdata, flags, rc):
    client.subscribe(topic, qos)


# rospy.init_node('mqtt_listener', anonymous=True)
# pub = rospy.Publisher('/mqtt_data', String, queue_size=1024)
client = paho.Client("client_001", clean_session=False)

client.on_connect = on_connect
client.on_message = on_message
print("Connecting to broker: ", broker)
client.max_queued_messages_set(256)
if count == 1:
    print("###########################")
    client.unsubscribe(topic)
    print("Hello unsub")

client.connect(broker, 1883)

# elif count == 2:
#     client.subscribe(topic, qos)
    
    # client.loop_stop()
    # client.disconnect()
    # time.sleep(10)
    
# client.connect(broker, 1883)
client.loop_forever()
