laukik-hase/human_arm_imitation/esp32_bno055/components/bno055/src/i2c_utils.c

#include "i2c_utils.h"

static const char *TAG_I2C = "i2c_utils";

esp_err_t i2c_master_init(void)
{
    int i2c_master_port = I2C_MASTER_NUM;
    i2c_config_t conf;
    conf.mode = I2C_MODE_MASTER;
    conf.sda_io_num = I2C_MASTER_SDA_IO;
    conf.sda_pullup_en = GPIO_PULLUP_ENABLE;
    conf.scl_io_num = I2C_MASTER_SCL_IO;
    conf.scl_pullup_en = GPIO_PULLUP_ENABLE;
    conf.master.clk_speed = I2C_MASTER_FREQ_HZ;
    i2c_param_config(i2c_master_port, &conf);
    i2c_set_timeout(i2c_master_port, BNO055_I2C_TIMEOUT);
    esp_err_t ret = i2c_driver_install(i2c_master_port, conf.mode, I2C_MASTER_RX_BUF_DISABLE, I2C_MASTER_TX_BUF_DISABLE, 0);
    if (ret != ESP_OK)
        ESP_LOGE(TAG_I2C, "I2C Master Initialization Failed!");
    return ret;
}

esp_err_t i2c_check_slave(uint8_t slave_addr)
{
    i2c_cmd_handle_t cmd = i2c_cmd_link_create();
    i2c_master_start(cmd);
    i2c_master_write_byte(cmd, slave_addr << 1 | I2C_MASTER_WRITE, I2C_MASTER_ACK);
    i2c_master_stop(cmd);
    esp_err_t ret = i2c_master_cmd_begin(I2C_MASTER_NUM, cmd, 10 / portTICK_RATE_MS);
    i2c_cmd_link_delete(cmd);

    if (ret == ESP_OK)
        ESP_LOGI(TAG_I2C, "Slave found: 0x%x", slave_addr);
    else
        ESP_LOGE(TAG_I2C, "Slave not found: 0x%x!", slave_addr);

    return ret;
}

esp_err_t i2c_mux_select(mpu_pos_t joint)
{
    uint8_t val = ((uint8_t)1) << (joint);

    i2c_cmd_handle_t cmd = i2c_cmd_link_create();
    i2c_master_start(cmd);
    i2c_master_write_byte(cmd, TCA9548_ADDR << 1 | I2C_MASTER_WRITE, I2C_MASTER_ACK);
    i2c_master_write_byte(cmd, val, I2C_MASTER_ACK);
    i2c_master_stop(cmd);
    esp_err_t ret = i2c_master_cmd_begin(I2C_MASTER_NUM, cmd, 10 / portTICK_RATE_MS);
    i2c_cmd_link_delete(cmd);

    return ret;
}

s8 BNO055_I2C_bus_write(u8 dev_addr, u8 reg_addr, u8 *reg_data, u8 cnt)
{
    u8 iError = BNO055_INIT_VALUE;
    i2c_cmd_handle_t cmd = i2c_cmd_link_create();

    i2c_master_start(cmd);
    i2c_master_write_byte(cmd, (dev_addr << 1) | I2C_MASTER_WRITE, 1);
    i2c_master_write_byte(cmd, reg_addr, 1);
    i2c_master_write(cmd, reg_data, cnt, 1);
    i2c_master_stop(cmd);

    esp_err_t espRc = i2c_master_cmd_begin(I2C_MASTER_NUM, cmd, 10 / portTICK_PERIOD_MS);
    i2c_cmd_link_delete(cmd);

    if (espRc == ESP_OK)
        iError = BNO055_SUCCESS;
    else
        iError = BNO055_ERROR;
    return (s8)iError;
}

s8 BNO055_I2C_bus_read(u8 dev_addr, u8 reg_addr, u8 *reg_data, u8 cnt)
{
    u8 iError = BNO055_INIT_VALUE;
    i2c_cmd_handle_t cmd = i2c_cmd_link_create();

    i2c_master_start(cmd);
    i2c_master_write_byte(cmd, (dev_addr << 1) | I2C_MASTER_WRITE, 1);
    i2c_master_write_byte(cmd, reg_addr, 1);

    i2c_master_start(cmd);
    i2c_master_write_byte(cmd, (dev_addr << 1) | I2C_MASTER_READ, 1);

    if (cnt > 1)
        i2c_master_read(cmd, reg_data, cnt - 1, I2C_MASTER_ACK);
    i2c_master_read_byte(cmd, reg_data + cnt - 1, I2C_MASTER_NACK);
    i2c_master_stop(cmd);

    esp_err_t espRc = i2c_master_cmd_begin(I2C_MASTER_NUM, cmd, 10 / portTICK_PERIOD_MS);
    i2c_cmd_link_delete(cmd);

    if (espRc == ESP_OK)
        iError = BNO055_SUCCESS;
    else
        iError = BNO055_ERROR;
    return (s8)iError;
}

void BNO055_delay_msek(u32 msek)
{
    vTaskDelay(msek / portTICK_PERIOD_MS);
}
