laukik-hase/human_arm_imitation/(commit log)

2020-09-08 added ros package for arm control on coppeliasim
    [turtlebot_arm.urdf]
2020-09-11 Extraction of link roll and pitch angles
    [imu.csv]
2020-09-13 rbdl verified without forces
    [open_manipulator.urdf, openx_90_deg_turn_angle.csv, turtlebot_arm.urdf]
2020-09-14 Joint angle - pitch and roll span calculated 1) Added multiple datasets 2) Fixed gyro raw data to angle conversion
    [imu.csv, imu1.csv, imu2.csv, imu3.csv, imu4.csv, imu5.csv, imu6.csv]
2020-09-14 position controlled imitation complete
    [openx_complex_angle.csv]
2020-12-10 Added ESP32 - MPU9250 files - extracted roll, pitch, yaw
2020-12-11 imitation on hardware arm
    [openx_45_deg_turn_angle.csv, path.csv, path_error.csv]
2021-01-22 Joint IMU Angle Extraction using Madgwick Filter 1) Extracted joint angles with low noise 2) Added PCB designs for controller board and IMU breakout
    [fyp_board_rev3.brd, fyp_board_rev3.sch, imu1.csv, imu2.csv, imu3.csv, imu4.csv, imu5.csv, imu6.csv]
2021-03-25 dynaban tests with pypot motor control
    [laukik_elbow.csv, laukik_elbow_radians.csv, manipuator4.urdf, manipulator.urdf, manipulator.xacro, manipulator_new.urdf, path.csv, walking_bill.csv]
2021-04-06 routine commit
    [QDDot.csv, QDot.csv, manipulator4.urdf, manipulator4.xacro, niryo_2motors_90deg_torque_ameya.ods, rbdl_torque_degrees_manipulator4_laukikelbow.ods, rbdl_torque_radians_manipulator4_laukikelbow.ods, single_motor.urdf]
2021-04-08 Added BNO055 MPU files
    [bno055.brd, bno055.sch, fyp_board_rev3.brd, fyp_board_rev3.sch, fyp_board_rev4.brd, fyp_board_rev4.sch, mpu9250.brd, mpu9250.sch]
2021-04-10 Interpolation for positioncontrol
    [curve_equ_output.csv, data.csv]
2021-04-10 Interpolation for multi motor position control
    [Pe.csv, Ps.csv]
2021-04-10 Interpolation for multi motor position control with single csv read
    [Ps_Pe.csv]
2021-04-10 Degree 5 polynomial interpolation for multi motor position control
2021-04-10 Adding edited csv file
    [Ps_Pe_new.csv]
2021-04-11 Adding csv for comparing torque values
    [new_compare_torque.csv]
2021-04-12 Final interpolation code for multi motor position control
2021-04-14 Interpolation final edited code for multi motor position control
2021-04-16 Interpolation with moving average values for multi motor position control
2021-04-17 cleaned up curve calculation code
    [Ps_Pe_new.csv, ps_pe_with_torque_1sec.csv, ps_pe_with_torque_slow_1sec_quartic.csv, testing.csv]
2021-04-18 Extracted 4 joint angles successfully 1) Corrected yaw joint angle calculation 2) Added calibration example with offsets stored to NVS
    [bno055_utils.c, bno055_utils.h, constants.h, main.c]
2021-04-20 Adding csv files for copsim circle motion
    [circle_angle.csv, circle_torque.csv]
2021-04-20 Adding csv files for all joints copsim circle motion
    [circle_all_angles.csv, circle_all_torques.csv]
2021-04-20 Final circle motion csv data
    [circle_all_angles_final.csv, circle_all_torques_final.csv]
2021-04-21 circular motion complete
    [circle_45_yaw_final.csv, circle_angle.csv, circle_angles.csv, circle_copsim.csv, circle_in_air.csv, circle_torque.csv, circle_torques.csv, demo2_imitation_wot_final.csv]
2021-05-02 csv files relocated
    [Pe.csv, Ps.csv, Ps_Pe.csv, Ps_Pe_CopSim.csv, Ps_Pe_Ys.csv, Ps_Pe_new (1).csv, Ps_Pe_new-urdf.csv, Ps_Pe_new.csv]
2021-05-03 Added Feature: MQTT 1) Sent joint angles over MQTT in JSON packets 2) Added WiFi and Mqtt utility functions
2021-05-03 Added Feature: Gripper control with GPIO 1) Gripper control with GPIO using ISR 2) Heading towards the end-goal -> sending timestamps, joint angles and gripper state over MQTT
2021-05-06 urdf with gripper complete
    [KR5_sixx_R650.urdf, Shoulder_sweep_with_torque.csv, base_link.STL, bicep.STL, calculate_MOI_from_meshlab.ods, copsim_torque_demo2.csv, elbow.STL, forearm.STL]
2021-05-12 real time imitation
    [out_of_limits.csv, pnp_2.csv, pytorque_1sec_100val.csv, pytorque_1sec_20val.csv, pytorque_90deg_100val.csv, pytorque_90deg_20val.csv, pytorque_high_sampling.csv, pytorque_slow_sampling.csv]
2021-11-13 Restructured files for better viewing
    [delay.csv, delay_wo_gripper.csv, delay_wo_motor.csv, dum.csv, imu1.csv, imu2.csv, imu3.csv, imu4.csv]
