laukik-hase/human_arm_imitation/(notices)

Notices in the files:
parts and their libraries:
Wurth_Elektronik_Electromechanic_Termina: Copyright: Würth Elektronik
